dalklein/esp_COP_meter/pinout_setup_8266_ssd1306_OLED.odt

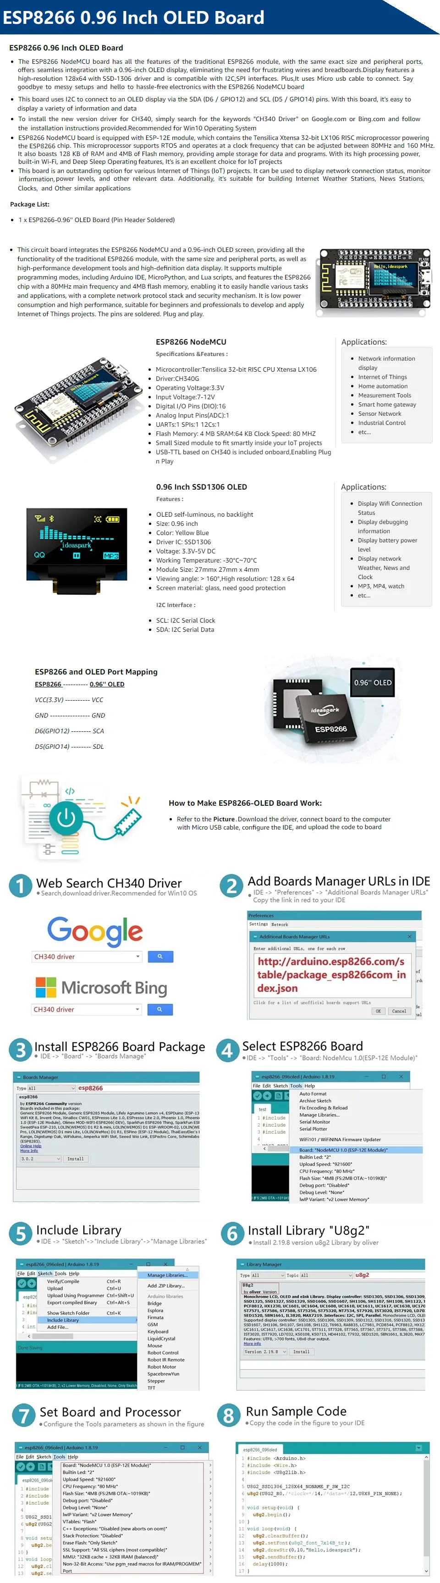
[picture p1: figure]
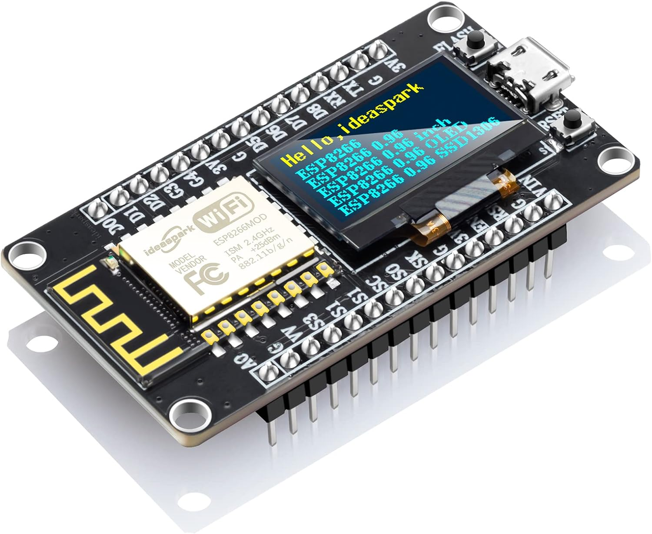
[picture p2: figure]
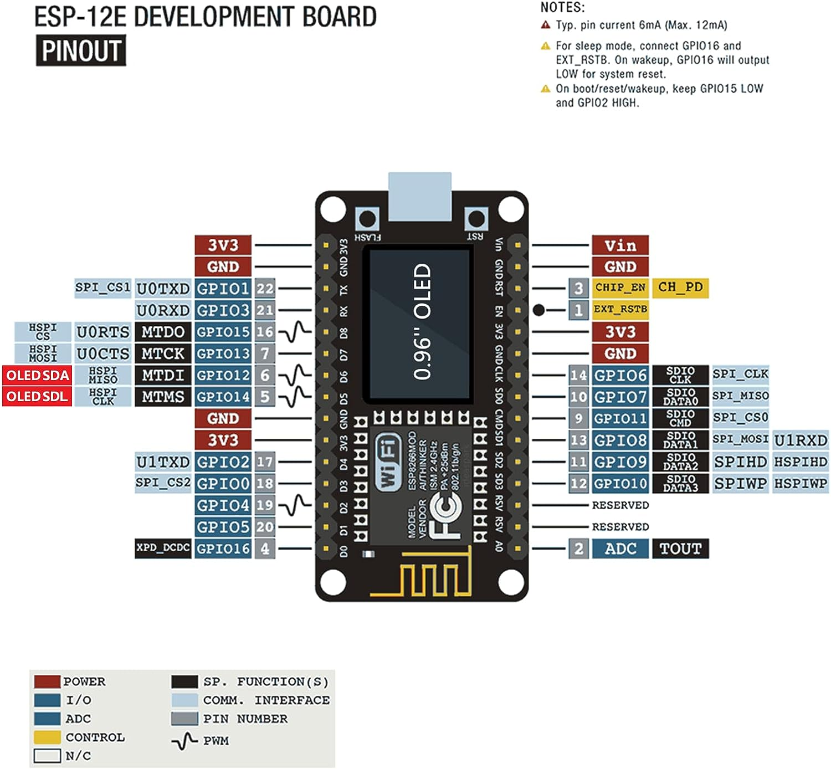
[picture p3: figure]

Grey 8266mod pin#

Error? 1&3 labels swapped

Caution, some errors here. Better reference: https://randomnerdtutorials.com/esp8266-pinout-reference-gpios/

Error, D5 is OLED SCL
